SenexCrenshaw/scclimate/SCClimate/SCClimate_Bottom.png

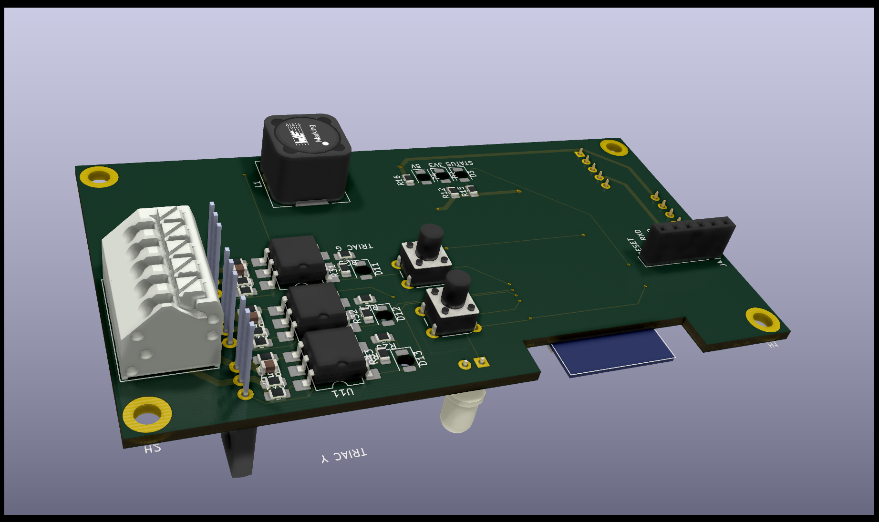
SCClimate/SCClimate_Bottom.png
