SenexCrenshaw/scclimate/SCClimate/SCClimate_Top.png

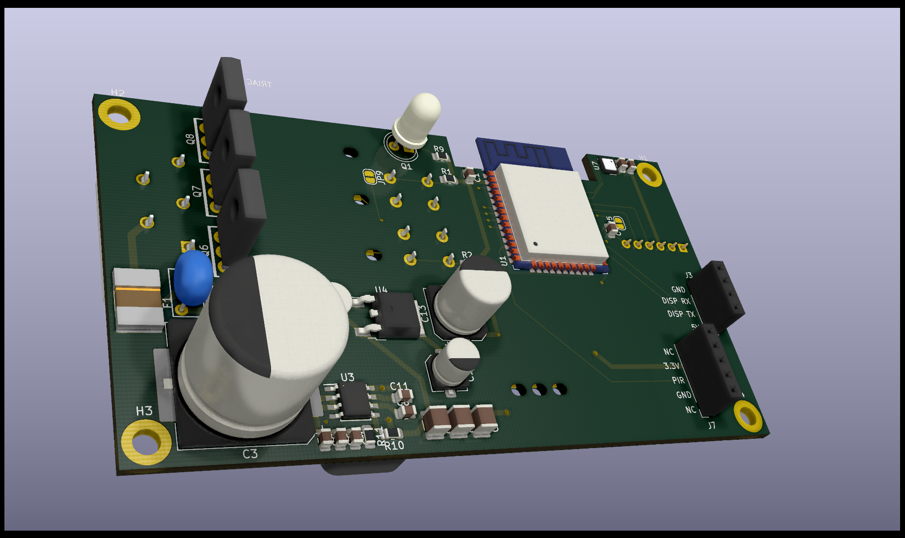
SCClimate/SCClimate_Top.png
