SenexCrenshaw/scclimate/SCClimate/SCClimate.kicad_pcb

## KiCad design SCClimate/SCClimate.kicad_pcb (2020-12-21)

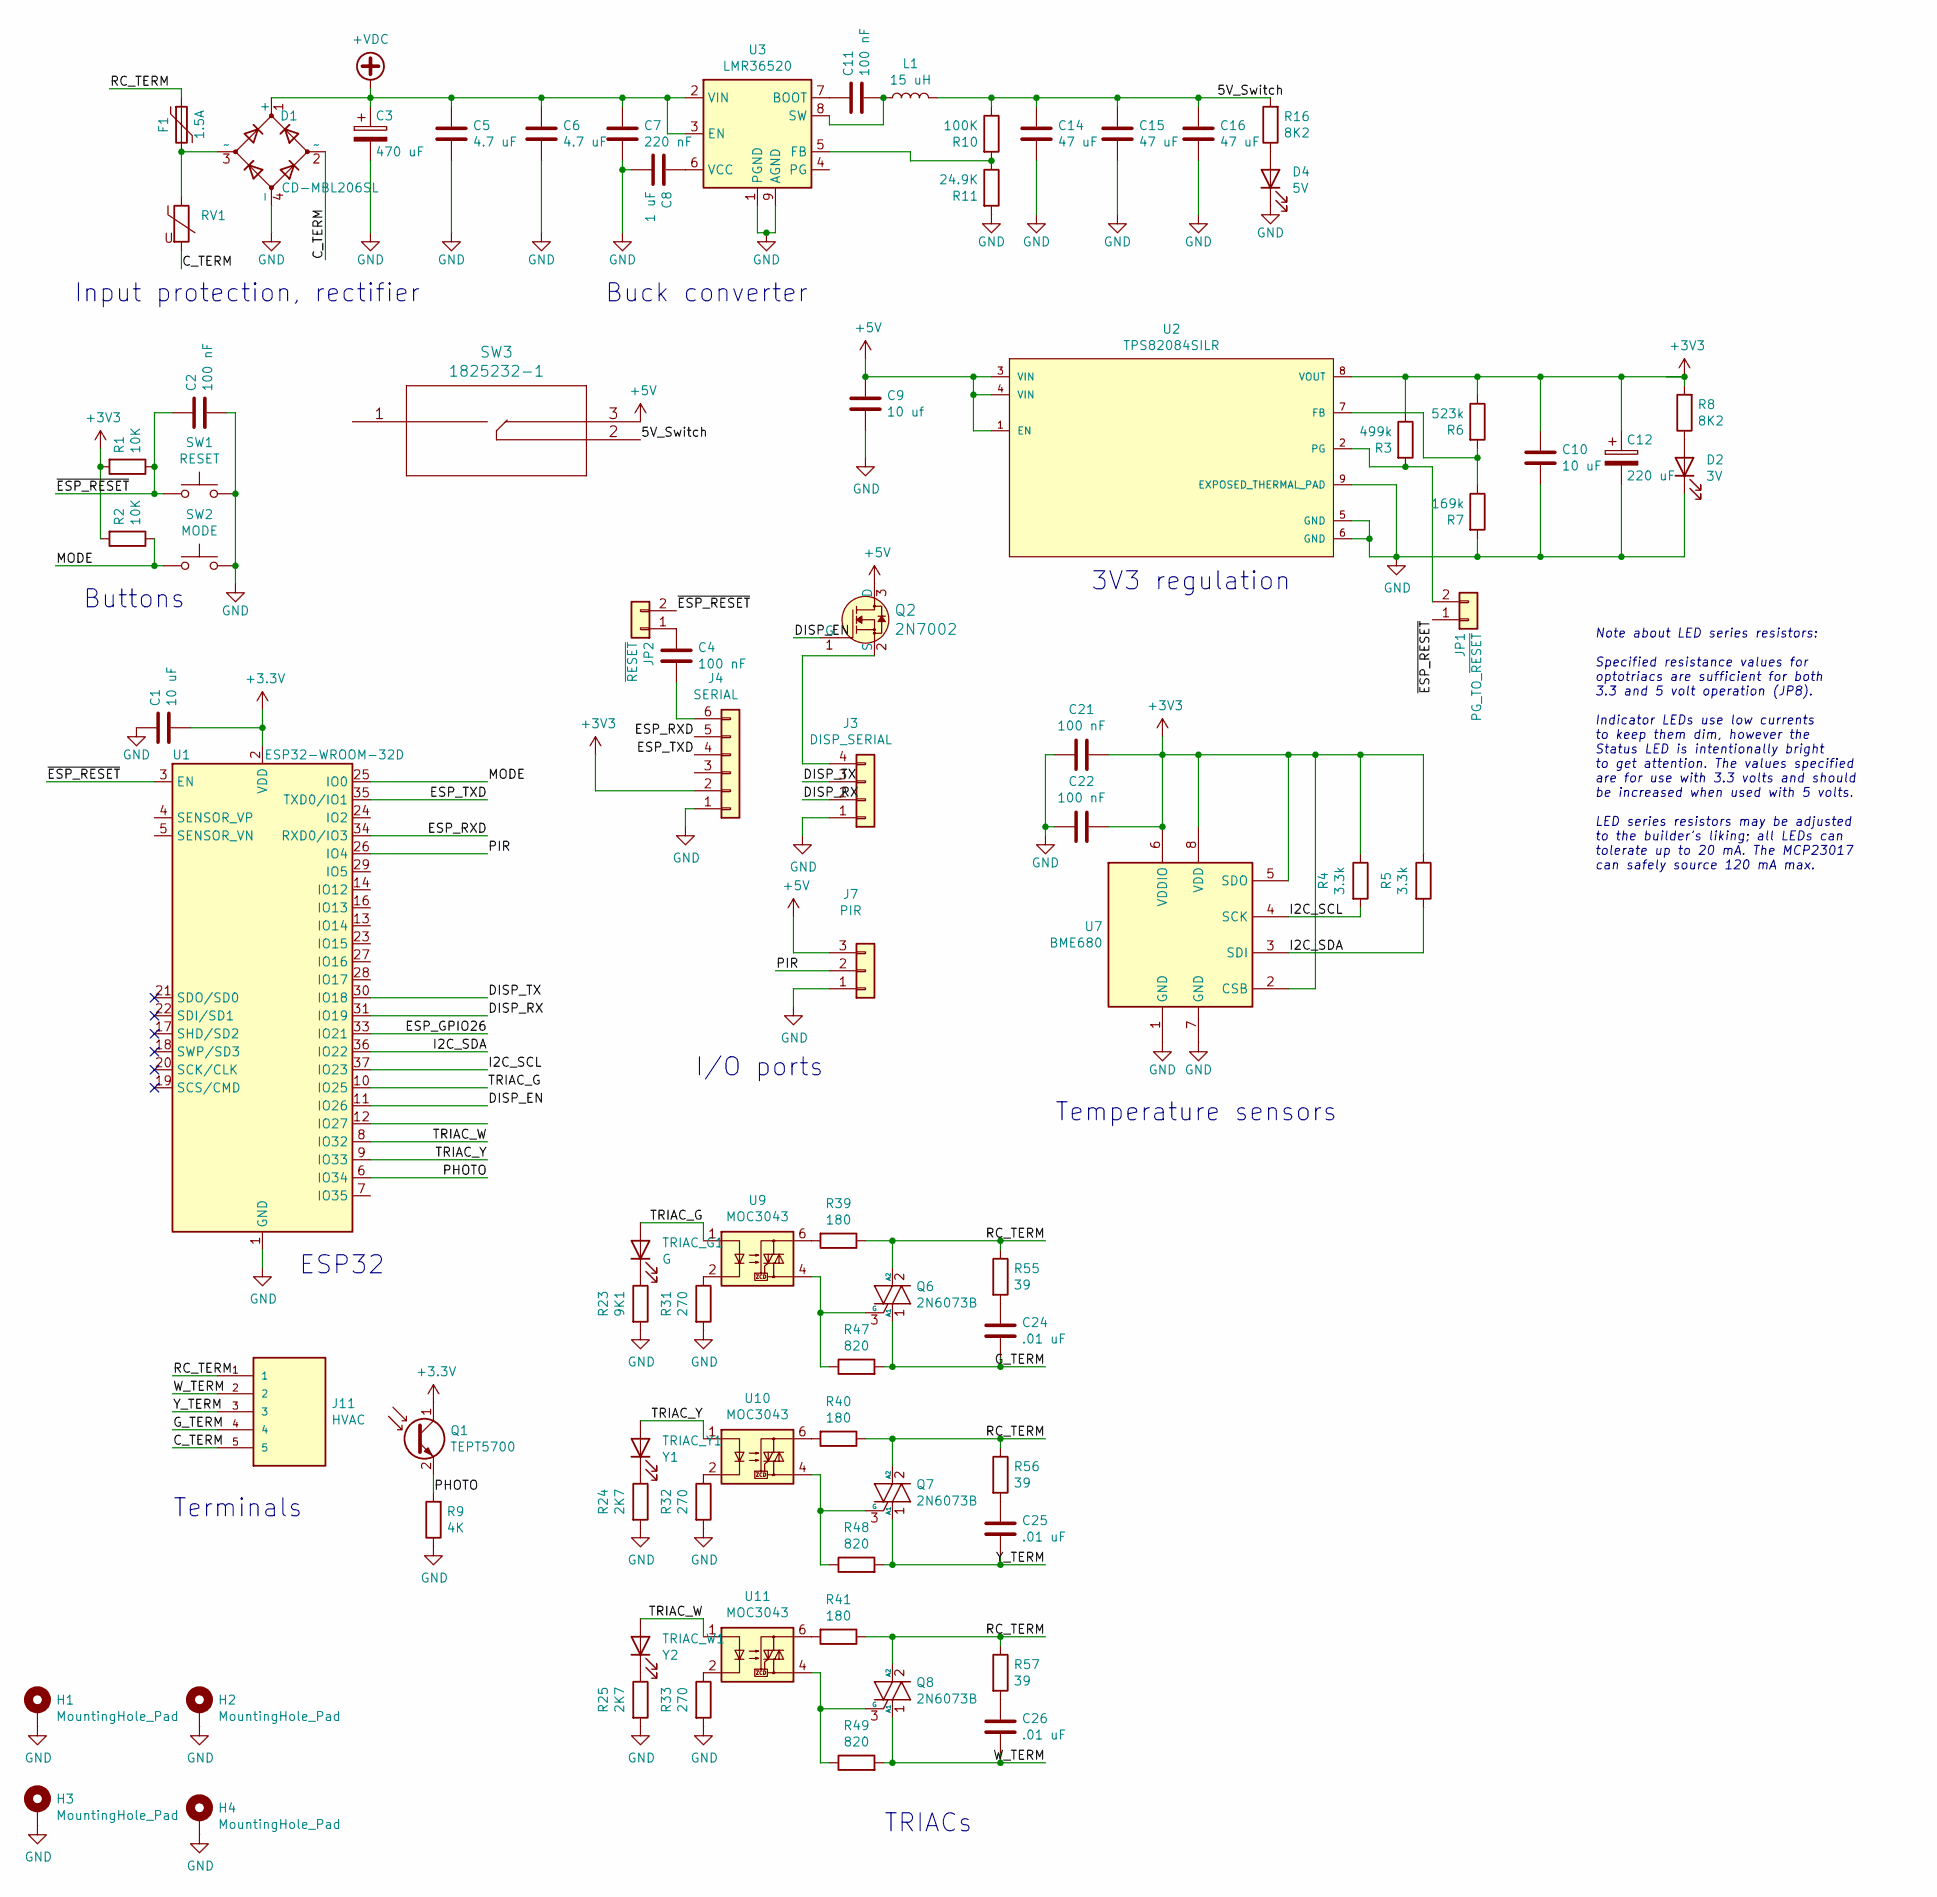
[picture p3: schematic SCClimate.sch, Climate and Sprinkler Controller]

Parts:
C1: 10 uF; C_0805_2012Metric; Part C2012X5R1V106K085AC
C2, C4, C11, C21, C22: 100 nF; C_0805_2012Metric; Part CC0805KRX7R7BB104
C3: 470 uF; CP_Elec_16x17.5; Part EEV-FK1H471M
C5, C6: 4.7 uF; C_0805_2012Metric; Part C2012X5R1H475K125AB
C7: 220 nF; C_0805_2012Metric; Part C2012X5R1H224K125AA
C8: 1 uF; C_0805_2012Metric; Part C0805C105K4RACTU
C9: 10 uf; C_0805_2012Metric; Part C0805C106K8PACTU‎
C10: 10 uF; C_0805_2012Metric; Part C0805C106K8PACTU‎
C12: 220 uF; CP_Elec_8x10; Part EEE-HB0J221AP
C14, C15, C16: 47 uF; C_1210_3225Metric; Part GRM32ER61C476KE15L
C24, C25, C26: .01 uF; C_0805_2012Metric; Part CC0805KRX7R9BB103
D1: CD-MBL206SL; Diode_Bridge_Vishay_MBLS; Part CD-MBL206SL
D2: 3V; LED_1206_3216Metric_ReverseMount_Hole1.8x2.4mm; Part 597-6901-607F
D4: 5V; LED_1206_3216Metric_ReverseMount_Hole1.8x2.4mm; Part 597-6901-607F
F1: 1.5A; Fuse_2920_7451Metric; Part 2920L150DR
H1, H2, H3, H4: MountingHole_Pad; MountingHole_3.2mm_M3_DIN965_Pad
J3: DISP_SERIAL; PinSocket_1x04_P2.54mm_Vertical
J4: SERIAL; PinSocket_1x06_P2.54mm_Vertical
J7: PIR; PinHeader_1x03_P2.54mm_Vertical
J11: HVAC; CUI_TBL002A-350-05GY-2GY
JP1: PG_TO_~RESET; PinHeader_1x02_P2.54mm_Vertical
JP2: ~RESET; PinHeader_1x02_P2.54mm_Vertical
L1: 15 uH; L_Wuerth_WE-PD-Typ-LS; Part 7447709150
Q1: TEPT5700; LED_D5.0mm_Clear; Part TEPT5700
Q2: 2N7002; SOT-23-3; MPN 2N7002; Digi-Key_PN 2N7002NCT-ND
Q6, Q7, Q8: 2N6073B; TO-225-3_Vertical; Part 2N6073BG
R1, R2: 10K; R_0805_2012Metric_Pad1.20x1.40mm_HandSolder; Part RC0805FR-0710KL
R3: 499k; R_0805_2012Metric_Pad1.20x1.40mm_HandSolder; Part CRCW0805499KFKEA
R4, R5: 3.3k; R_0805_2012Metric_Pad1.20x1.40mm_HandSolder; Part RT0805FRE07180RL
R6: 523k; R_0805_2012Metric_Pad1.20x1.40mm_HandSolder; Part CRCW0805523KFKEA
R7: 169k; R_0805_2012Metric_Pad1.20x1.40mm_HandSolder; Part CRCW0805169KFKEA
R8, R16: 8K2; R_0805_2012Metric_Pad1.20x1.40mm_HandSolder; Part RT0805FRE078K2L
R9: 4K; R_0805_2012Metric_Pad1.20x1.40mm_HandSolder; Part RC0805FR-07100KL
R10: 100K; R_0805_2012Metric_Pad1.20x1.40mm_HandSolder; Part RC0805FR-07100KL
R11: 24.9K; R_0805_2012Metric_Pad1.20x1.40mm_HandSolder; Part RT0805FRE0724K9L
R23: 9K1; R_0805_2012Metric_Pad1.20x1.40mm_HandSolder; Part RT0805FRE079K1L
R24, R25: 2K7; R_0805_2012Metric_Pad1.20x1.40mm_HandSolder; Part RT0805FRE072K7L
R31, R32, R33: 270; R_0805_2012Metric_Pad1.20x1.40mm_HandSolder; Part RT0805FRE07270RL
R39, R40, R41: 180; R_0805_2012Metric_Pad1.20x1.40mm_HandSolder; Part RT0805FRE07180RL
R47, R48, R49: 820; R_0805_2012Metric_Pad1.20x1.40mm_HandSolder; Part RT0805FRE07820RL
R55, R56, R57: 39; R_0805_2012Metric_Pad1.20x1.40mm_HandSolder; Part ERJ-P06J390V
RV1: B72205S0400K101; RV_Disc_D7mm_W4mm_P5mm; Part B72205S0400K101
SW1: RESET; SW_PUSH_6mm_H8mm; Part PTS645VK582LFS
SW2: MODE; SW_PUSH_6mm_H8mm; Part PTS645VK582LFS
SW3: 1825232-1
TRIAC_G1: G; LED_1206_3216Metric_ReverseMount_Hole1.8x2.4mm; Part APTL3216ZGC
TRIAC_W1: Y2; LED_1206_3216Metric_ReverseMount_Hole1.8x2.4mm; Part APTL3216QBC/D
TRIAC_Y1: Y1; LED_1206_3216Metric_ReverseMount_Hole1.8x2.4mm; Part APTL3216QBC/D
U1: ESP32-WROOM-32D; ESP32-WROOM-32; Part ESP32-WROOM-32D
U2: TPS82084SILR; Texas_Instruments-SIL0008C-0-0-MFG; output voltage 0.8-6V; mouser part number 595-TPS82084SILR; digikey description DC DC CONVERTER 0.8-6V 2A
U3: LMR36520; Texas_HSOP-8-1EP_3.9x4.9mm_P1.27mm_ThermalVias; Part LMR36520ADDAR
U7: BME680; Bosch_LGA-8_3x3mm_P0.8mm_ClockwisePinNumbering
U9, U10, U11: MOC3043; SMDIP-6_W9.53mm; Part MOC3043SM

Connections:
+5V: C9.1, J7.3, Q2.3 (D), SW3.3, U2.1 (EN), U2.3 (VIN), U2.4 (VIN)
+VDC: C3.1, C5.1, C6.1, C7.1, D1.1 (+), U3.2 (VIN), U3.3 (EN)
/5V_Switch: C14.1, C15.1, C16.1, L1.2, R10.1, R16.2, SW3.2
/C_TERM: D1.2 (~~), J11.5, RV1.2
/DISP_EN: Q2.1 (G), U1.11 (IO26)
/DISP_RX: J3.2, U1.31 (IO19)
/DISP_TX: J3.3, U1.30 (IO18)
/ESP_RXD: J4.5, U1.34 (RXD0/IO3)
/ESP_TXD: J4.4, U1.35 (TXD0/IO1)
/G_TERM: C24.2, J11.4, Q6.1 (A1), R47.2
/I2C_SCL: R4.2, U1.37 (IO23), U7.4 (SCK)
/I2C_SDA: R5.2, U1.36 (IO22), U7.3 (SDI)
/MODE: R2.1, SW2.1, U1.25 (IO0)
/PHOTO: Q1.2 (E), R9.2, U1.6 (IO34)
/PIR: J7.2, U1.26 (IO4)
/RC_TERM: F1.1, J11.1, Q6.2 (A2), Q7.2 (A2), Q8.2 (A2), R39.1, R40.1, R41.1, R55.1, R56.1, R57.1
/TRIAC_G: TRIAC_G1.2 (A), U1.10 (IO25), U9.1
/TRIAC_W: TRIAC_W1.2 (A), U1.8 (IO32), U11.1
/TRIAC_Y: TRIAC_Y1.2 (A), U1.9 (IO33), U10.1
/W_TERM: C26.2, J11.2, Q8.1 (A1), R49.2
/Y_TERM: C25.2, J11.3, Q7.1 (A1), R48.2
/~ESP_RESET: C2.1, JP1.1, JP2.2, R1.1, SW1.2, U1.3 (EN)
GND: C1.1, C2.2, C3.2, C5.2, C6.2, C7.2, C8.2, C9.2, C10.2, C12.2, C14.2, C15.2, C16.2, C21.2, C22.2, D1.4 (-), D2.1 (K), D4.1 (K), H1.1, H2.1, H3.1, H4.1, J3.1, J4.1, J7.1, R7.2, R9.1, R11.2, R23.2, R24.2, R25.2, R31.2, R32.2, R33.2, SW1.1, SW2.2, U1.1 (GND), U1.15 (GND), U1.38 (GND), U1.39 (GND), U2.5 (GND), U2.6 (GND), U2.9 (EXPOSED_THERMAL_PAD), U3.1 (PGND), U3.9 (AGND), U7.1 (GND), U7.7 (GND)
unnamed: C4.1, JP2.1
unnamed: C4.2, J4.6
unnamed: C8.1, U3.6 (VCC)
unnamed: C11.1, U3.7 (BOOT)
unnamed: C11.2, L1.1, U3.8 (SW)
unnamed: C24.1, R55.2
unnamed: C25.1, R56.2
unnamed: C26.1, R57.2
unnamed: D1.3 (~~), F1.2, RV1.1
unnamed: D2.2 (A), R8.1
unnamed: D4.2 (A), R16.1
unnamed: J3.4, Q2.2 (S)
unnamed: JP1.2, R3.2, U2.2 (PG)
unnamed: Q6.3 (G), R47.1, U9.4
unnamed: Q7.3 (G), R48.1, U10.4
unnamed: Q8.3 (G), R49.1, U11.4
unnamed: R6.2, R7.1, U2.7 (FB)
unnamed: R10.2, R11.1, U3.5 (FB)
unnamed: R23.1, TRIAC_G1.1 (K)
unnamed: R24.1, TRIAC_Y1.1 (K)
unnamed: R25.1, TRIAC_W1.1 (K)
unnamed: R31.1, U9.2
unnamed: R32.1, U10.2
unnamed: R33.1, U11.2
unnamed: R39.2, U9.6
unnamed: R40.2, U10.6
unnamed: R41.2, U11.6

Notes on the sheet:
Buck converter
3V3 regulation
TRIACs
Terminals
Temperature sensors
I/O ports
ESP32
Buttons
Input protection, rectifier
Note about LED series resistors: Specified resistance values for optotriacs are sufficient for both 3.3 and 5 volt operation (JP8). Indicator LEDs use low currents to keep them dim, however the Status LED is intentionally bright to get attention. The values specified are for use with 3.3 volts and 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
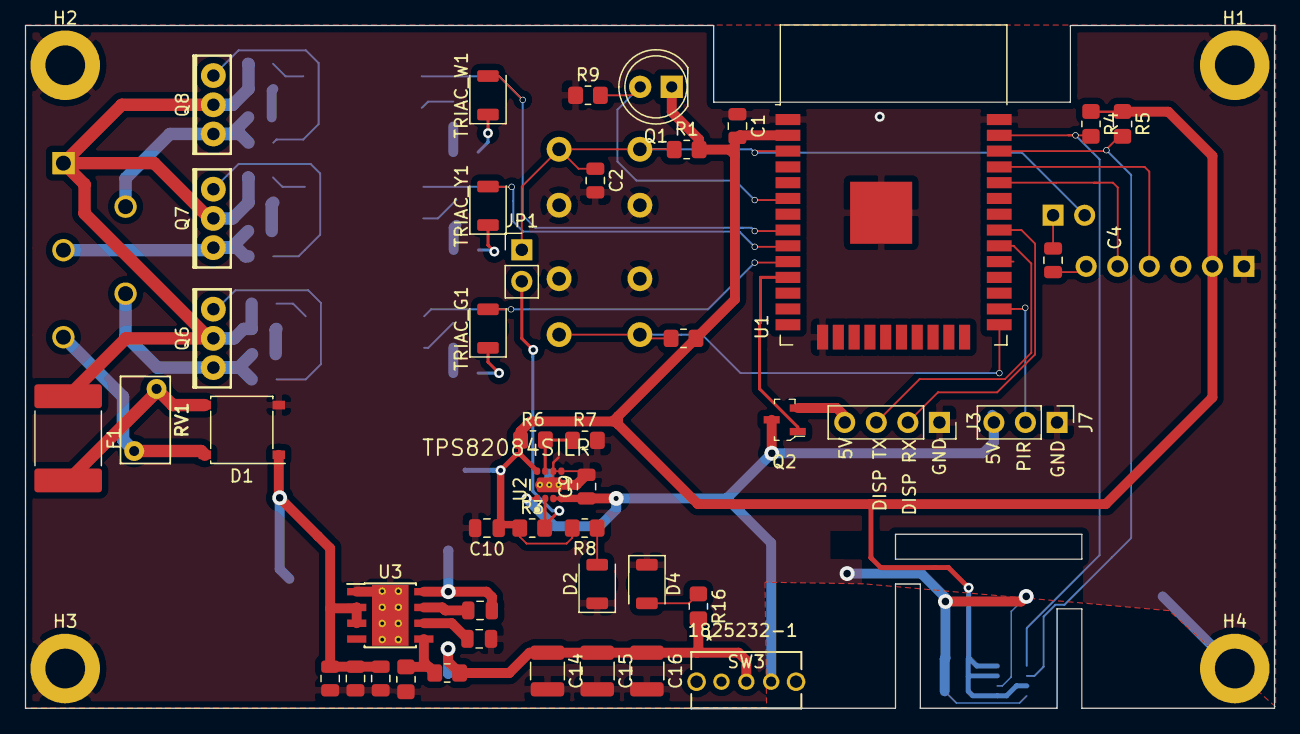
[picture p4: board SCClimate.kicad_pcb from above]

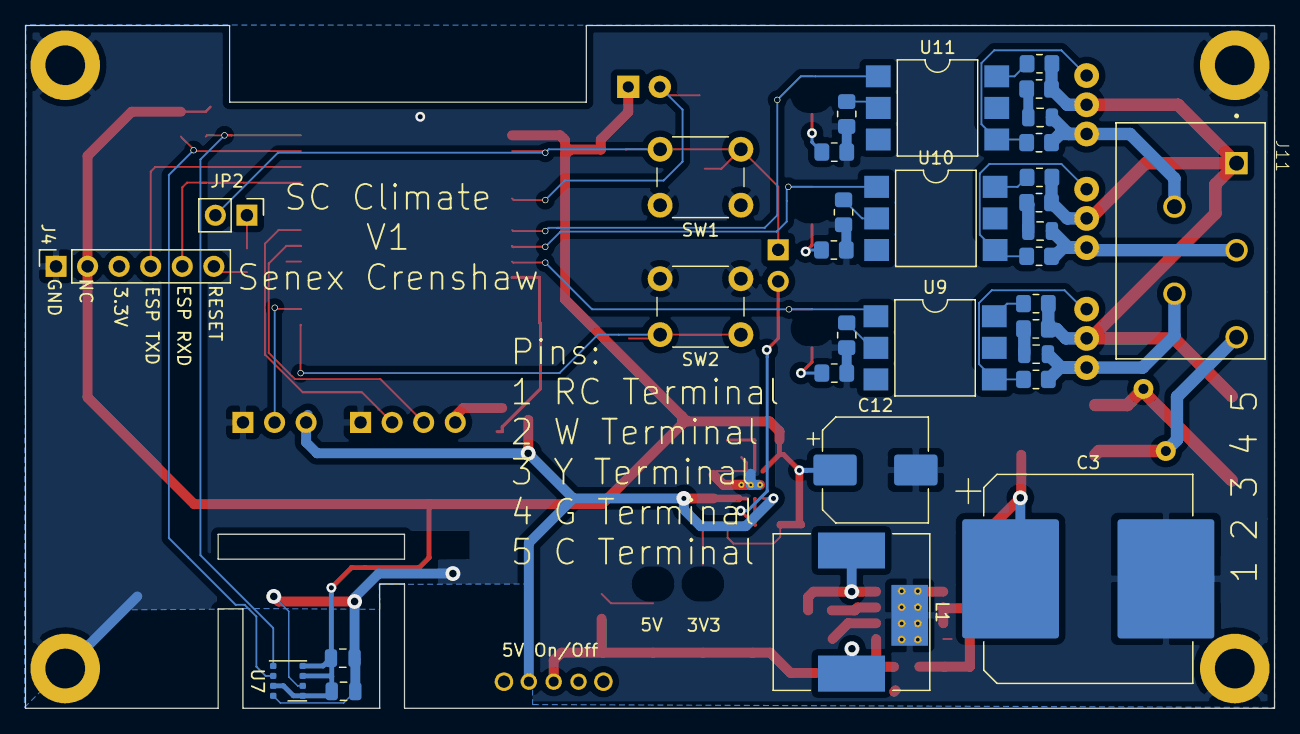
[picture p5: board SCClimate.kicad_pcb from below]

Board: 2 copper layers, 100.5 x 54.9 mm, 81 parts (32 on the bottom side), 51 nets.
