SenexCrenshaw/scclimate/(commit log)

2020-12-17 Changed a few things around for better placement
    [SCClimate.kicad_pcb, SCClimate.sch]
2020-12-21 Moved 680 to bottom and switched ldo to buck
    [SCClimate.kicad_pcb, SCClimate.sch]
2020-12-21 Moved 680 to other side of board
    [SCClimate.kicad_pcb, SCClimate.sch]
